MR-DOS/generator_5351_rect_sine/brd1.jpg

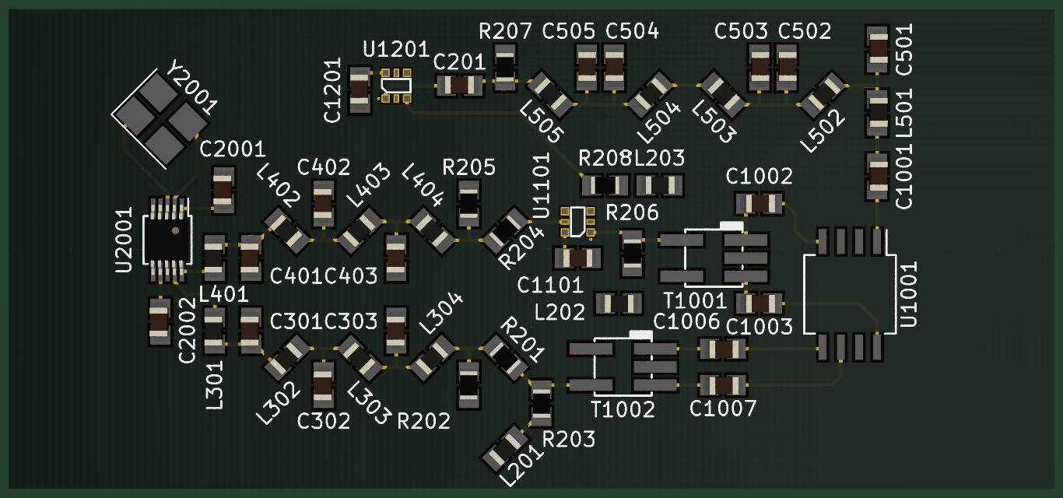
brd1.jpg
