MR-DOS/generator_5351_rect_sine/brd5.jpg

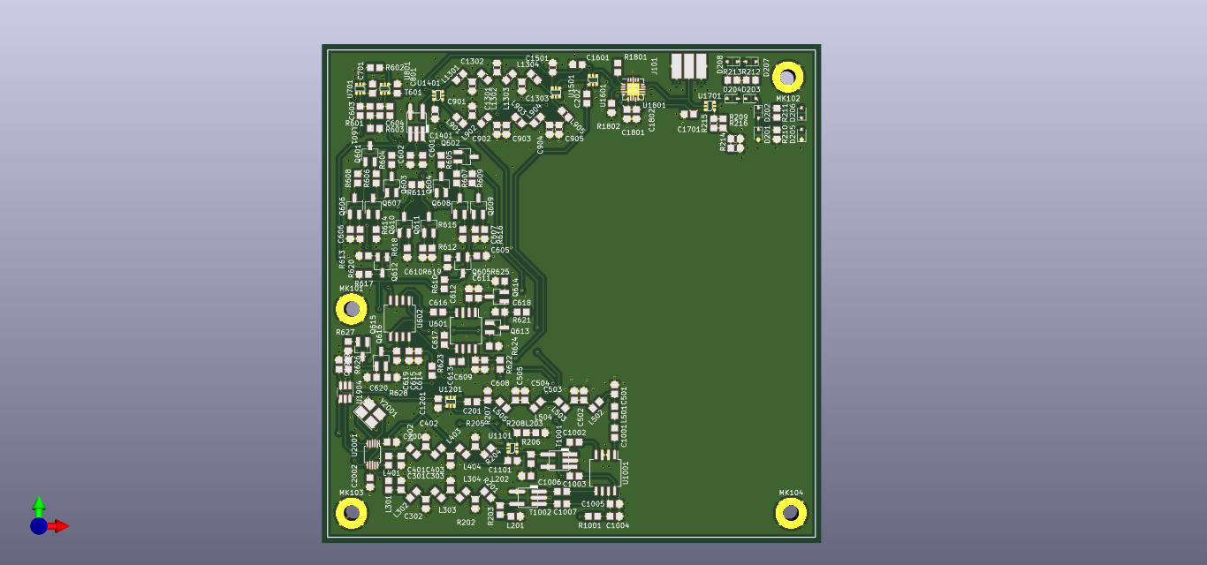
brd5.jpg
