MR-DOS/generator_5351_rect_sine/brd2.jpg

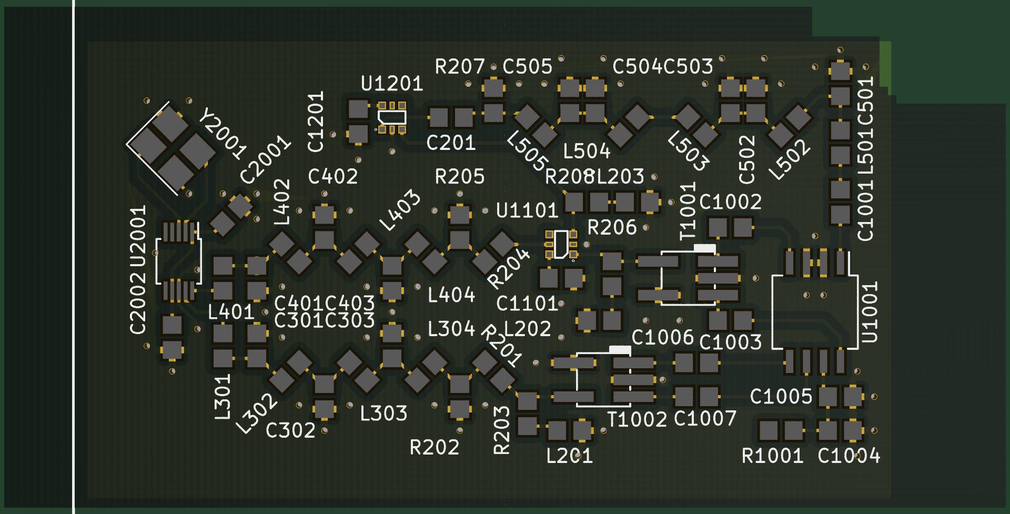
brd2.jpg
