MR-DOS/generator_5351_rect_sine/brd3.jpg

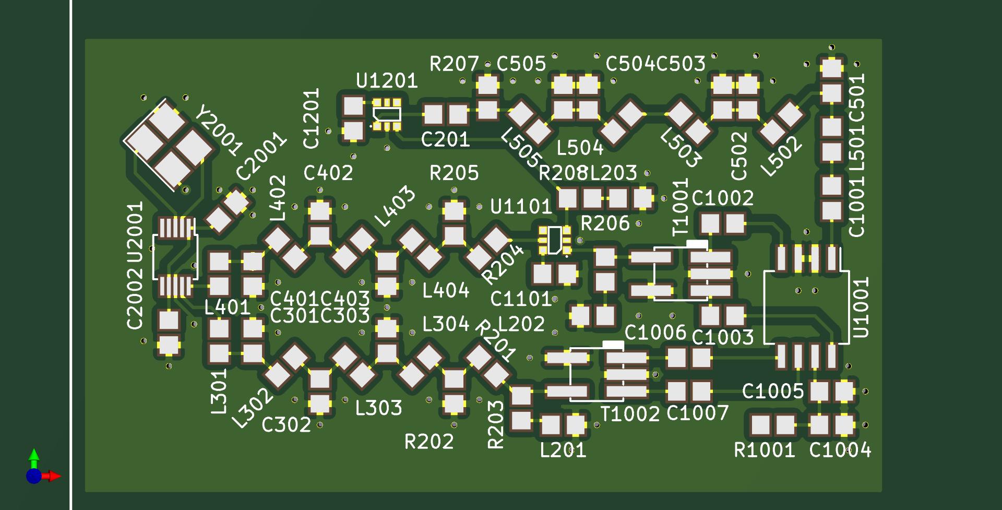
brd3.jpg
