MR-DOS/generator_5351_rect_sine/brd4.jpg

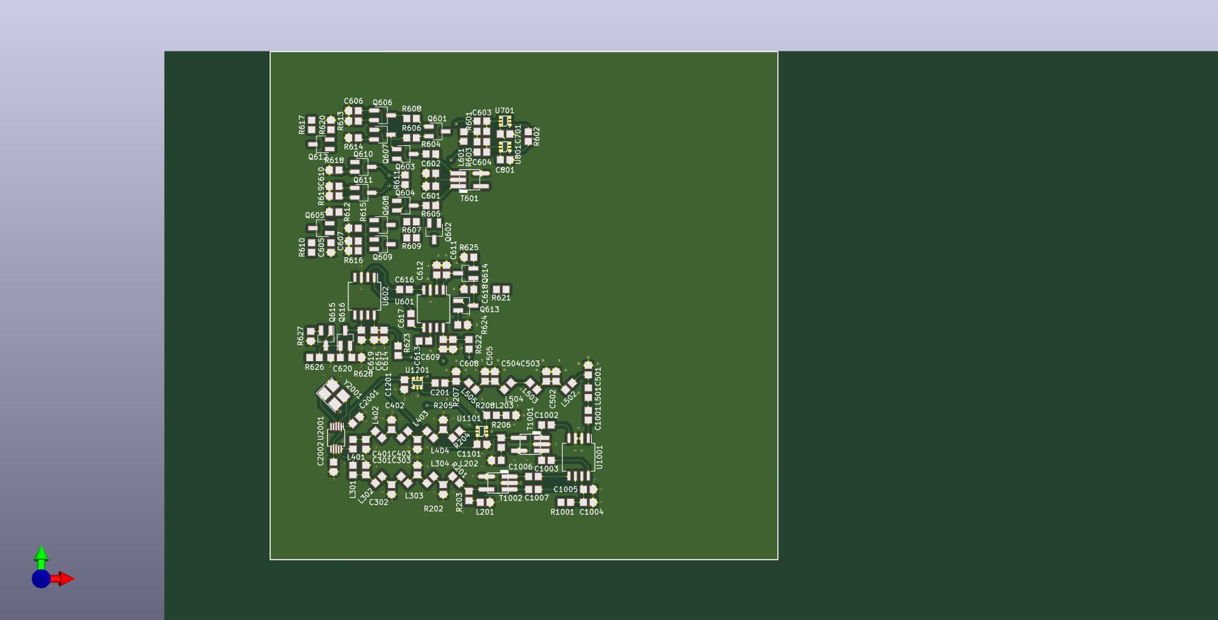
brd4.jpg
