MR-DOS/generator_5351_rect_sine/generator_5351_rect_sine.kicad_pcb

## KiCad design generator_5351_rect_sine.kicad_pcb (2018-12-11)

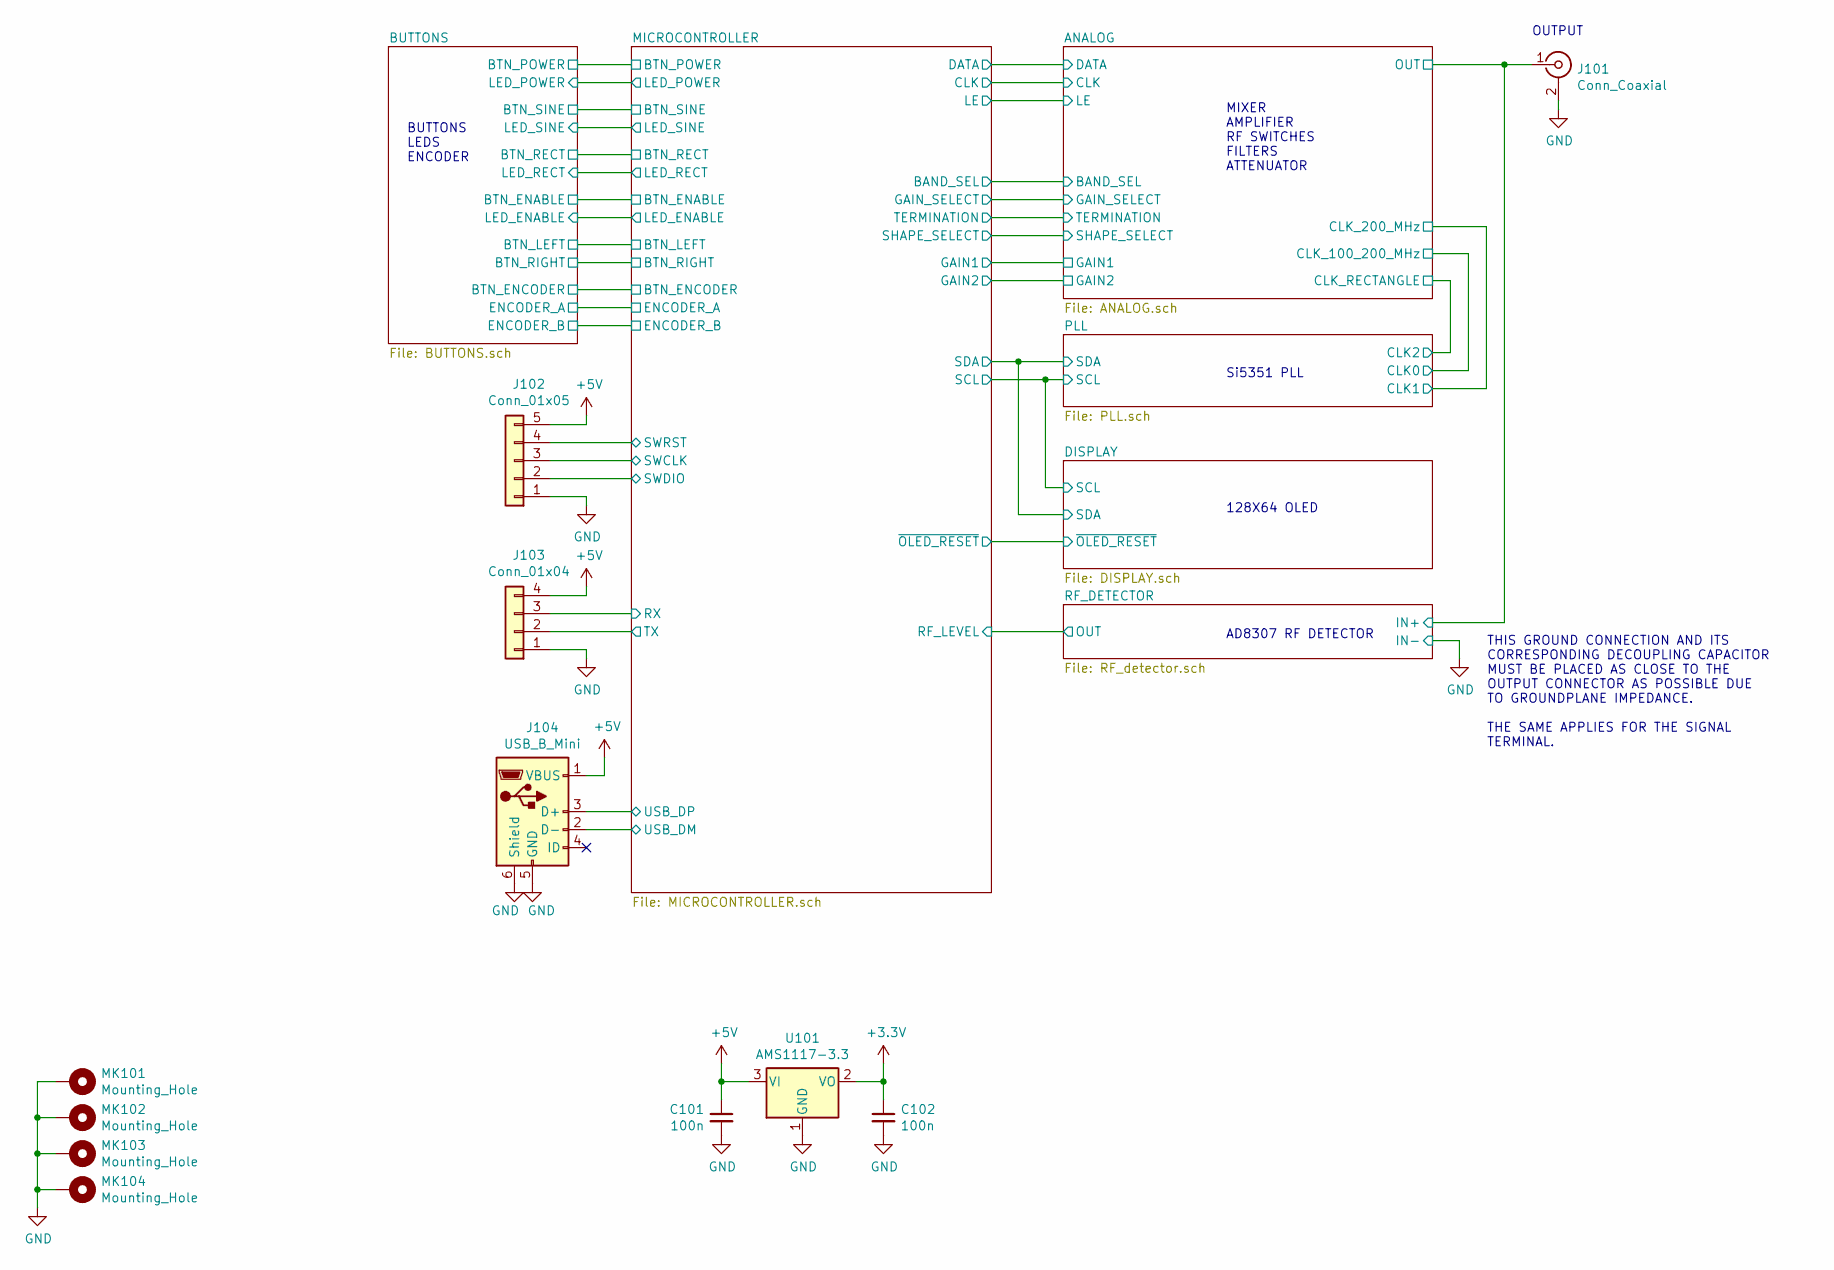
[picture p6: schematic generator_5351_rect_sine.sch]

Parts:
C101, C102: 100n; C_0805_2012Metric_Pad1.33x1.40mm_HandSolder
J101: Conn_Coaxial; Molex_SMA_Jack_Edge_Mount_Chinese
J102: Conn_01x05; JST_VH_B5PS-VH_1x05_P3.96mm_Horizontal
J103: Conn_01x04; JST_VH_B4PS-VH_1x04_P3.96mm_Horizontal
J104: USB_B_Mini; USB_Mini-B_Lumberg_2486_01_Horizontal
MK101, MK102, MK103, MK104: Mounting_Hole; MountingHole_3.2mm_M3_Pad
U101: AMS1117-3.3; SOT-223-3_TabPin2

Connections:
+5V: C101.1, J102.5, J103.4, J104.1 (VBUS), U101.3 (VI); also elsewhere on the board
/MICROCONTROLLER/RX: J103.3; also elsewhere on the board
/MICROCONTROLLER/SWCLK: J102.3; also elsewhere on the board
/MICROCONTROLLER/SWDIO: J102.2; also elsewhere on the board
/MICROCONTROLLER/SWRST: J102.4; also elsewhere on the board
/MICROCONTROLLER/TX: J103.2; also elsewhere on the board
/MICROCONTROLLER/USB_DM: J104.2 (D-); also elsewhere on the board
/MICROCONTROLLER/USB_DP: J104.3 (D+); also elsewhere on the board
/RF_DETECTOR/IN+: J101.1 (In); also elsewhere on the board
SW_GND: C101.2, C102.2, J101.2 (Ext), J102.1, J103.1, J104.5 (GND), J104.6 (Shield), MK101.1, MK102.1, MK103.1, MK104.1, U101.1 (GND); also elsewhere on the board

Notes on the sheet:
THIS GROUND CONNECTION AND ITS CORRESPONDING DECOUPLING CAPACITOR MUST BE PLACED AS CLOSE TO THE OUTPUT CONNECTOR AS POSSIBLE DUE TO GROUNDPLANE IMPEDANCE. THE SAME APPLIES FOR THE SIGNAL TERMINAL.
MIXER AMPLIFIER RF SWITCHES FILTERS ATTENUATOR
Si5351 PLL
128X64 OLED
AD8307 RF DETECTOR
OUTPUT
BUTTONS LEDS ENCODER

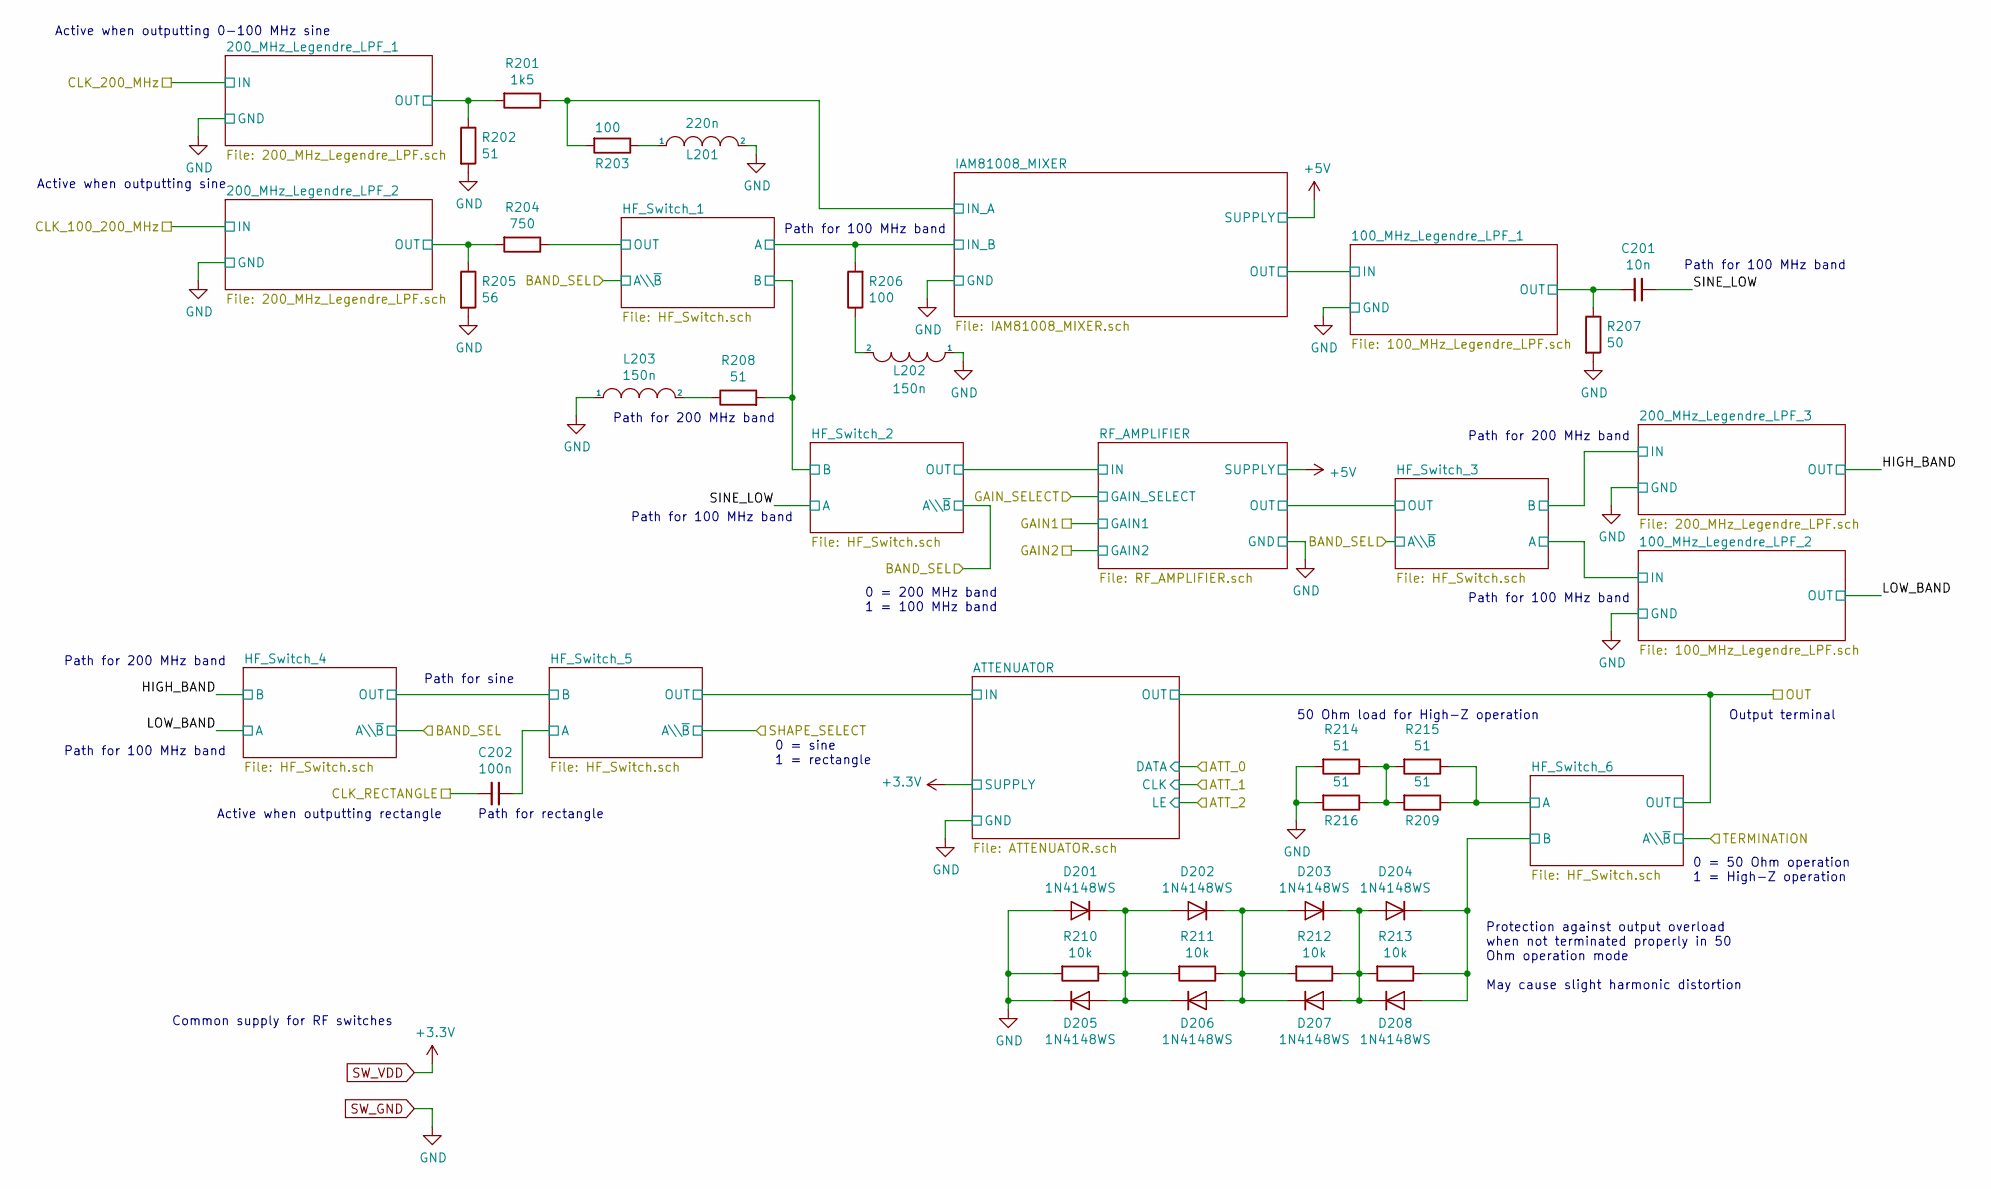
[picture p7: schematic ANALOG.sch]

Parts:
C201: 10n; C_0805_2012Metric_Pad1.33x1.40mm_HandSolder
C202: 100n; C_0805_2012Metric_Pad1.33x1.40mm_HandSolder
D201, D202, D203, D204, D205, D206, D207, D208: 1N4148WS; D_SOD-323
L201: 220n; L_0805_2012Metric_Pad1.33x1.40mm_HandSolder
L202, L203: 150n; L_0805_2012Metric_Pad1.33x1.40mm_HandSolder
R201: 1k5; R_0805_2012Metric_Pad1.33x1.40mm_HandSolder
R202, R208, R209, R214, R215, R216: 51; R_0805_2012Metric_Pad1.33x1.40mm_HandSolder
R203, R206: 100; R_0805_2012Metric_Pad1.33x1.40mm_HandSolder
R204: 750; R_0805_2012Metric_Pad1.33x1.40mm_HandSolder
R205: 56; R_0805_2012Metric_Pad1.33x1.40mm_HandSolder
R207: 50; R_0805_2012Metric_Pad1.33x1.40mm_HandSolder
R210, R211, R212, R213: 10k; R_0805_2012Metric_Pad1.33x1.40mm_HandSolder

Connections:
/ANALOG/100_MHz_Legendre_LPF_1/OUT: C201.2, R207.1; also elsewhere on the board
/ANALOG/200_MHz_Legendre_LPF_1/OUT: R201.2, R202.1; also elsewhere on the board
/ANALOG/200_MHz_Legendre_LPF_2/OUT: R204.2, R205.1; also elsewhere on the board
/ANALOG/HF_Switch_1/A: R206.2; also elsewhere on the board
/ANALOG/HF_Switch_1/B: R208.2; also elsewhere on the board
/ANALOG/HF_Switch_1/OUT: R204.1; also elsewhere on the board
/ANALOG/HF_Switch_5/A: C202.1; also elsewhere on the board
/ANALOG/HF_Switch_6/A: R209.1, R215.1; also elsewhere on the board
/ANALOG/HF_Switch_6/B: D204.1 (K), D208.2 (A), R213.1; also elsewhere on the board
/ANALOG/IAM81008_MIXER/IN_A: R201.1, R203.2; also elsewhere on the board
/ANALOG/SINE_LOW: C201.1; also elsewhere on the board
/PLL/CLK2: C202.2; also elsewhere on the board
unnamed: D201.1 (K), D202.2 (A), D205.2 (A), D206.1 (K), R210.1, R211.2
unnamed: D202.1 (K), D203.2 (A), D206.2 (A), D207.1 (K), R211.1, R212.2
unnamed: D203.1 (K), D204.2 (A), D207.2 (A), D208.1 (K), R212.1, R213.2
unnamed: L201.1, R203.1
unnamed: L202.2, R206.1
unnamed: L203.2, R208.1
unnamed: R209.2, R214.1, R215.2, R216.1
SW_GND: D201.2 (A), D205.1 (K), L201.2, L202.1, L203.1, R202.2, R205.2, R207.2, R210.2, R214.2, R216.2; also elsewhere on the board

Notes on the sheet:
Path for 100 MHz band
Path for 200 MHz band
Common supply for RF switches
Active when outputting 0-100 MHz sine
Active when outputting sine
0 = sine 1 = rectangle
Path for sine
Path for rectangle
Protection against output overload when not terminated properly in 50 Ohm operation mode May cause slight harmonic distortion
50 Ohm load for High-Z operation
0 = 50 Ohm operation 1 = High-Z operation
Output terminal
0 = 200 MHz band 1 = 100 MHz band
Active when outputting rectangle

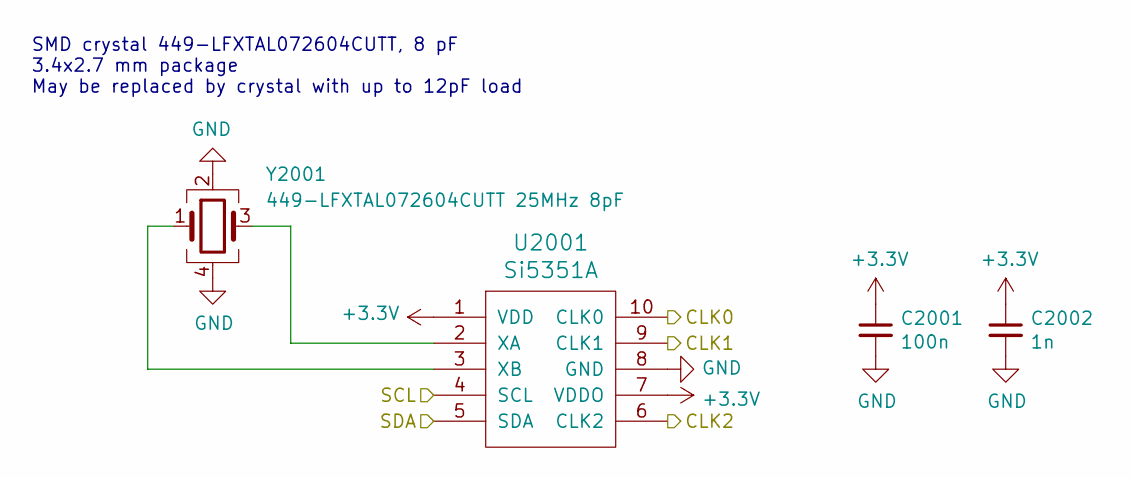
[picture p8: schematic PLL.sch]

Parts:
C2001: 100n; C_0805_2012Metric_Pad1.33x1.40mm_HandSolder
C2002: 1n; C_0805_2012Metric_Pad1.33x1.40mm_HandSolder
U2001: Si5351A; MSOP-10_3x3mm_P0.5mm
Y2001: 449-LFXTAL072604CUTT 25MHz 8pF; Crystal_SMD_3225-4Pin_3.2x2.5mm_HandSoldering

Connections:
/DISPLAY/SCL: U2001.4 (SCL); also elsewhere on the board
/DISPLAY/SDA: U2001.5 (SDA); also elsewhere on the board
/PLL/CLK0: U2001.10 (CLK0); also elsewhere on the board
/PLL/CLK1: U2001.9 (CLK1); also elsewhere on the board
/PLL/CLK2: U2001.6 (CLK2); also elsewhere on the board
unnamed: U2001.2 (XA), Y2001.3
unnamed: U2001.3 (XB), Y2001.1
SW_GND: C2001.2, C2002.2, U2001.8 (GND), Y2001.2, Y2001.4; also elsewhere on the board

Notes on the sheet:
SMD crystal 449-LFXTAL072604CUTT, 8 pF 3.4x2.7 mm package May be replaced by crystal with up to 12pF load

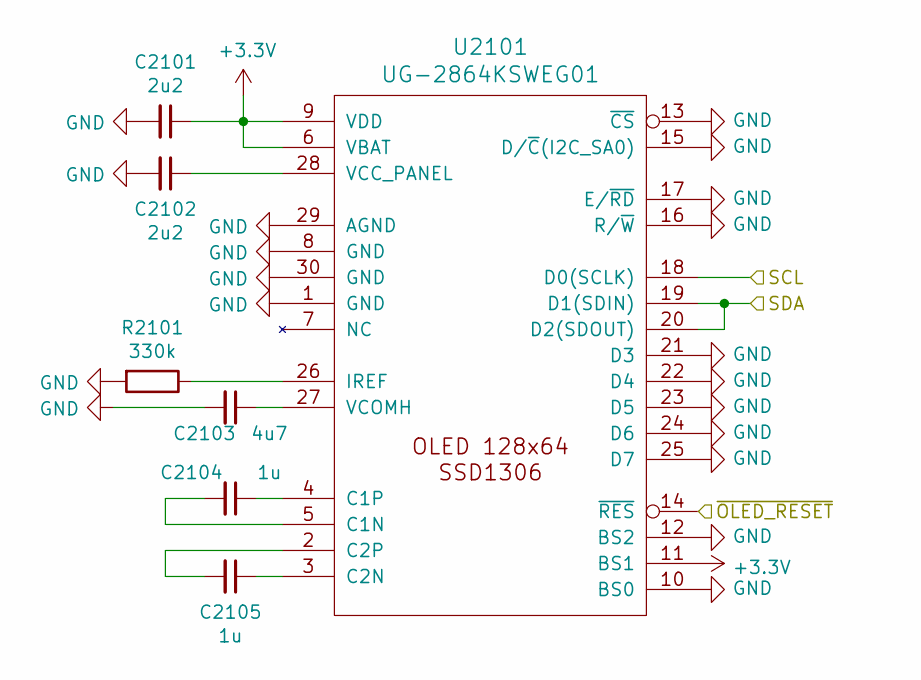
[picture p9: schematic DISPLAY.sch]

Parts:
C2101, C2102: 2u2; C_0805_2012Metric_Pad1.33x1.40mm_HandSolder
C2103: 4u7; C_0805_2012Metric_Pad1.33x1.40mm_HandSolder
C2104, C2105: 1u; C_0805_2012Metric_Pad1.33x1.40mm_HandSolder
R2101: 330k; R_0805_2012Metric_Pad1.33x1.40mm_HandSolder
U2101: UG-2864KSWEG01

Connections:
/DISPLAY/SCL: U2101.18 (D0(SCLK)); also elsewhere on the board
/DISPLAY/SDA: U2101.19 (D1(SDIN)), U2101.20 (D2(SDOUT)); also elsewhere on the board
/DISPLAY/~OLED_RESET: U2101.14 (~RES); also elsewhere on the board
unnamed: C2102.1, U2101.28 (VCC_PANEL)
unnamed: C2103.1, U2101.27 (VCOMH)
unnamed: C2104.1, U2101.4 (C1P)
unnamed: C2104.2, U2101.5 (C1N)
unnamed: C2105.1, U2101.3 (C2N)
unnamed: C2105.2, U2101.2 (C2P)
unnamed: R2101.1, U2101.26 (IREF)
SW_GND: C2101.2, C2102.2, C2103.2, R2101.2, U2101.1 (GND), U2101.8 (GND), U2101.10 (BS0), U2101.12 (BS2), U2101.13 (~CS), U2101.15 (D/~C~(I2C_SA0)), U2101.16 (R/~W), U2101.17 (E/~RD), U2101.21 (D3), U2101.22 (D4), U2101.23 (D5), U2101.24 (D6), U2101.25 (D7), U2101.29 (AGND), U2101.30 (GND); also elsewhere on the board

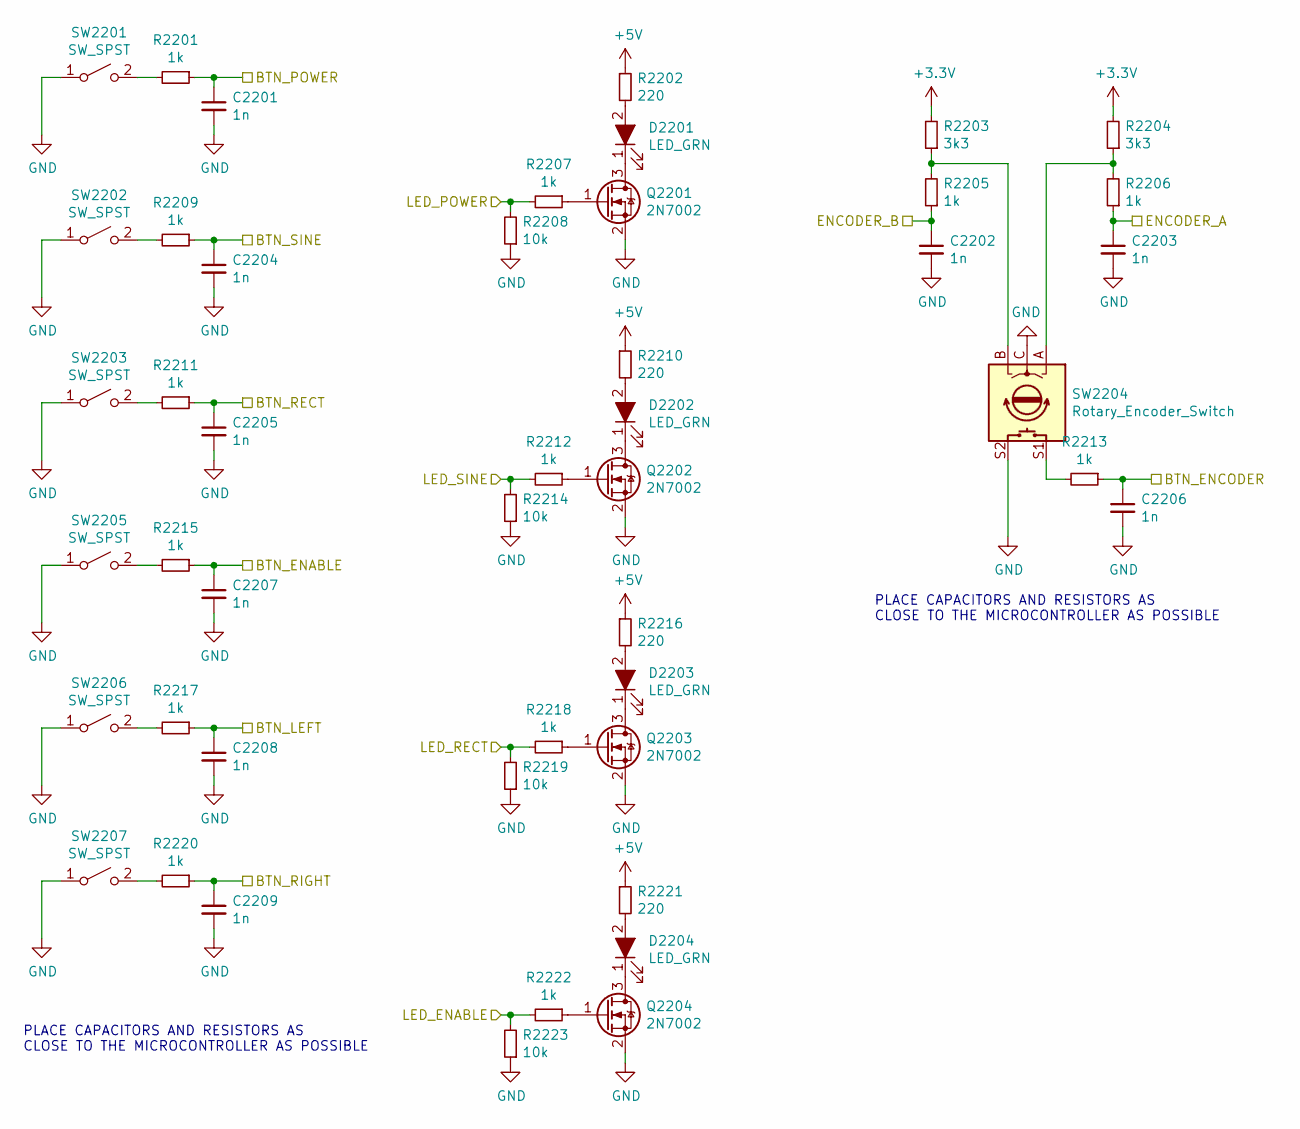
[picture p10: schematic BUTTONS.sch]

Parts:
C2201, C2202, C2203, C2204, C2205, C2206, C2207, C2208, C2209: 1n; C_0805_2012Metric_Pad1.33x1.40mm_HandSolder
D2201, D2202, D2203, D2204: LED_GRN; C_0603_1608Metric_Pad1.05x0.95mm_HandSolder
Q2201, Q2202, Q2203, Q2204: 2N7002; SOT-23_Handsoldering
R2201, R2205, R2206, R2207, R2209, R2211, R2212, R2213, R2215, R2217, R2218, R2220, R2222: 1k; R_0805_2012Metric_Pad1.33x1.40mm_HandSolder
R2202, R2210, R2216, R2221: 220; R_0805_2012Metric_Pad1.33x1.40mm_HandSolder
R2203, R2204: 3k3; R_0805_2012Metric_Pad1.33x1.40mm_HandSolder
R2208, R2214, R2219, R2223: 10k; R_0805_2012Metric_Pad1.33x1.40mm_HandSolder
SW2201, SW2202, SW2203, SW2205, SW2206, SW2207: SW_SPST; SW_SPST_TL3342
SW2204: Rotary_Encoder_Switch; RotaryEncoder_Alps_EC11E-Switch_Vertical_H20mm

Connections:
+5V: R2202.1, R2210.1, R2216.1, R2221.1; also elsewhere on the board
/BUTTONS/BTN_ENABLE: C2207.1, R2215.1; also elsewhere on the board
/BUTTONS/BTN_ENCODER: C2206.1, R2213.1; also elsewhere on the board
/BUTTONS/BTN_LEFT: C2208.1, R2217.1; also elsewhere on the board
/BUTTONS/BTN_POWER: C2201.1, R2201.1; also elsewhere on the board
/BUTTONS/BTN_RECT: C2205.1, R2211.1; also elsewhere on the board
/BUTTONS/BTN_RIGHT: C2209.1, R2220.1; also elsewhere on the board
/BUTTONS/BTN_SINE: C2204.1, R2209.1; also elsewhere on the board
/BUTTONS/ENCODER_A: C2203.1, R2206.1; also elsewhere on the board
/BUTTONS/ENCODER_B: C2202.1, R2205.1; also elsewhere on the board
/BUTTONS/LED_ENABLE: R2222.2, R2223.2; also elsewhere on the board
/BUTTONS/LED_POWER: R2207.2, R2208.2; also elsewhere on the board
/BUTTONS/LED_RECT: R2218.2, R2219.2; also elsewhere on the board
/BUTTONS/LED_SINE: R2212.2, R2214.2; also elsewhere on the board
unnamed: D2201.1 (K), Q2201.3 (D)
unnamed: D2201.2 (A), R2202.2
unnamed: D2202.1 (K), Q2202.3 (D)
unnamed: D2202.2 (A), R2210.2
unnamed: D2203.1 (K), Q2203.3 (D)
unnamed: D2203.2 (A), R2216.2
unnamed: D2204.1 (K), Q2204.3 (D)
unnamed: D2204.2 (A), R2221.2
unnamed: Q2201.1 (G), R2207.1
unnamed: Q2202.1 (G), R2212.1
unnamed: Q2203.1 (G), R2218.1
unnamed: Q2204.1 (G), R2222.1
unnamed: R2201.2, SW2201.2 (B)
unnamed: R2203.1, R2205.2, SW2204.B
unnamed: R2204.1, R2206.2, SW2204.A
unnamed: R2209.2, SW2202.2 (B)
unnamed: R2211.2, SW2203.2 (B)
unnamed: R2213.2, SW2204.S1
unnamed: R2215.2, SW2205.2 (B)
unnamed: R2217.2, SW2206.2 (B)
unnamed: R2220.2, SW2207.2 (B)
SW_GND: C2201.2, C2202.2, C2203.2, C2204.2, C2205.2, C2206.2, C2207.2, C2208.2, C2209.2, Q2201.2 (S), Q2202.2 (S), Q2203.2 (S), Q2204.2 (S), R2208.1, R2214.1, R2219.1, R2223.1, SW2201.1 (A), SW2202.1 (A), SW2203.1 (A), SW2204.C, SW2204.S2, SW2205.1 (A), SW2206.1 (A), SW2207.1 (A); also elsewhere on the board

Notes on the sheet:
PLACE CAPACITORS AND RESISTORS AS CLOSE TO THE MICROCONTROLLER AS POSSIBLE

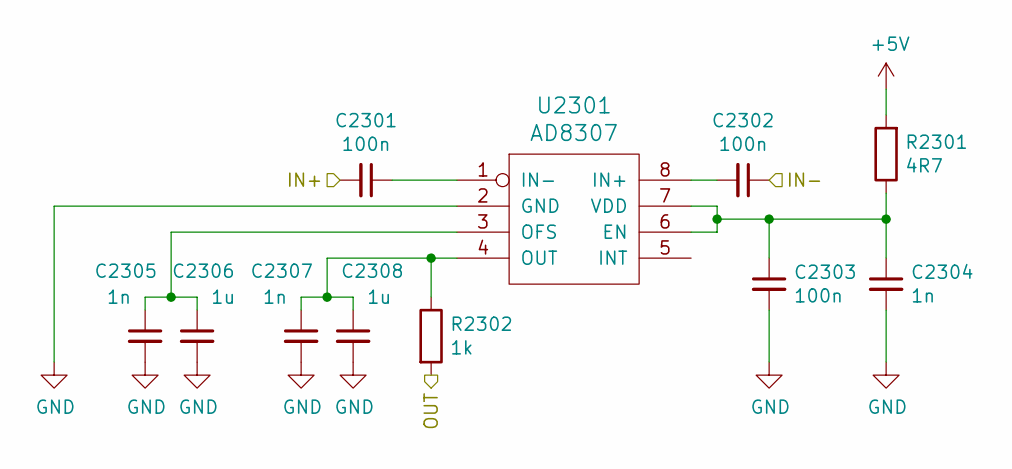
[picture p11: schematic RF_detector.sch]

Parts:
C2301, C2302, C2303: 100n; C_0805_2012Metric_Pad1.33x1.40mm_HandSolder
C2304, C2305, C2307: 1n; C_0805_2012Metric_Pad1.33x1.40mm_HandSolder
C2306, C2308: 1u; C_0805_2012Metric_Pad1.33x1.40mm_HandSolder
R2301: 4R7; R_0805_2012Metric_Pad1.33x1.40mm_HandSolder
R2302: 1k; R_0805_2012Metric_Pad1.33x1.40mm_HandSolder
U2301: AD8307; SOIC-8_3.9x4.9mm_P1.27mm

Connections:
+5V: R2301.2; also elsewhere on the board
/RF_DETECTOR/IN+: C2301.2; also elsewhere on the board
/RF_DETECTOR/OUT: R2302.2; also elsewhere on the board
unnamed: C2301.1, U2301.1 (IN-)
unnamed: C2302.2, U2301.8 (IN+)
unnamed: C2303.1, C2304.1, R2301.1, U2301.6 (EN), U2301.7 (VDD)
unnamed: C2305.1, C2306.1, U2301.3 (OFS)
unnamed: C2307.1, C2308.1, R2302.1, U2301.4 (OUT)
SW_GND: C2302.1, C2303.2, C2304.2, C2305.2, C2306.2, C2307.2, C2308.2, U2301.2 (GND); also elsewhere on the board

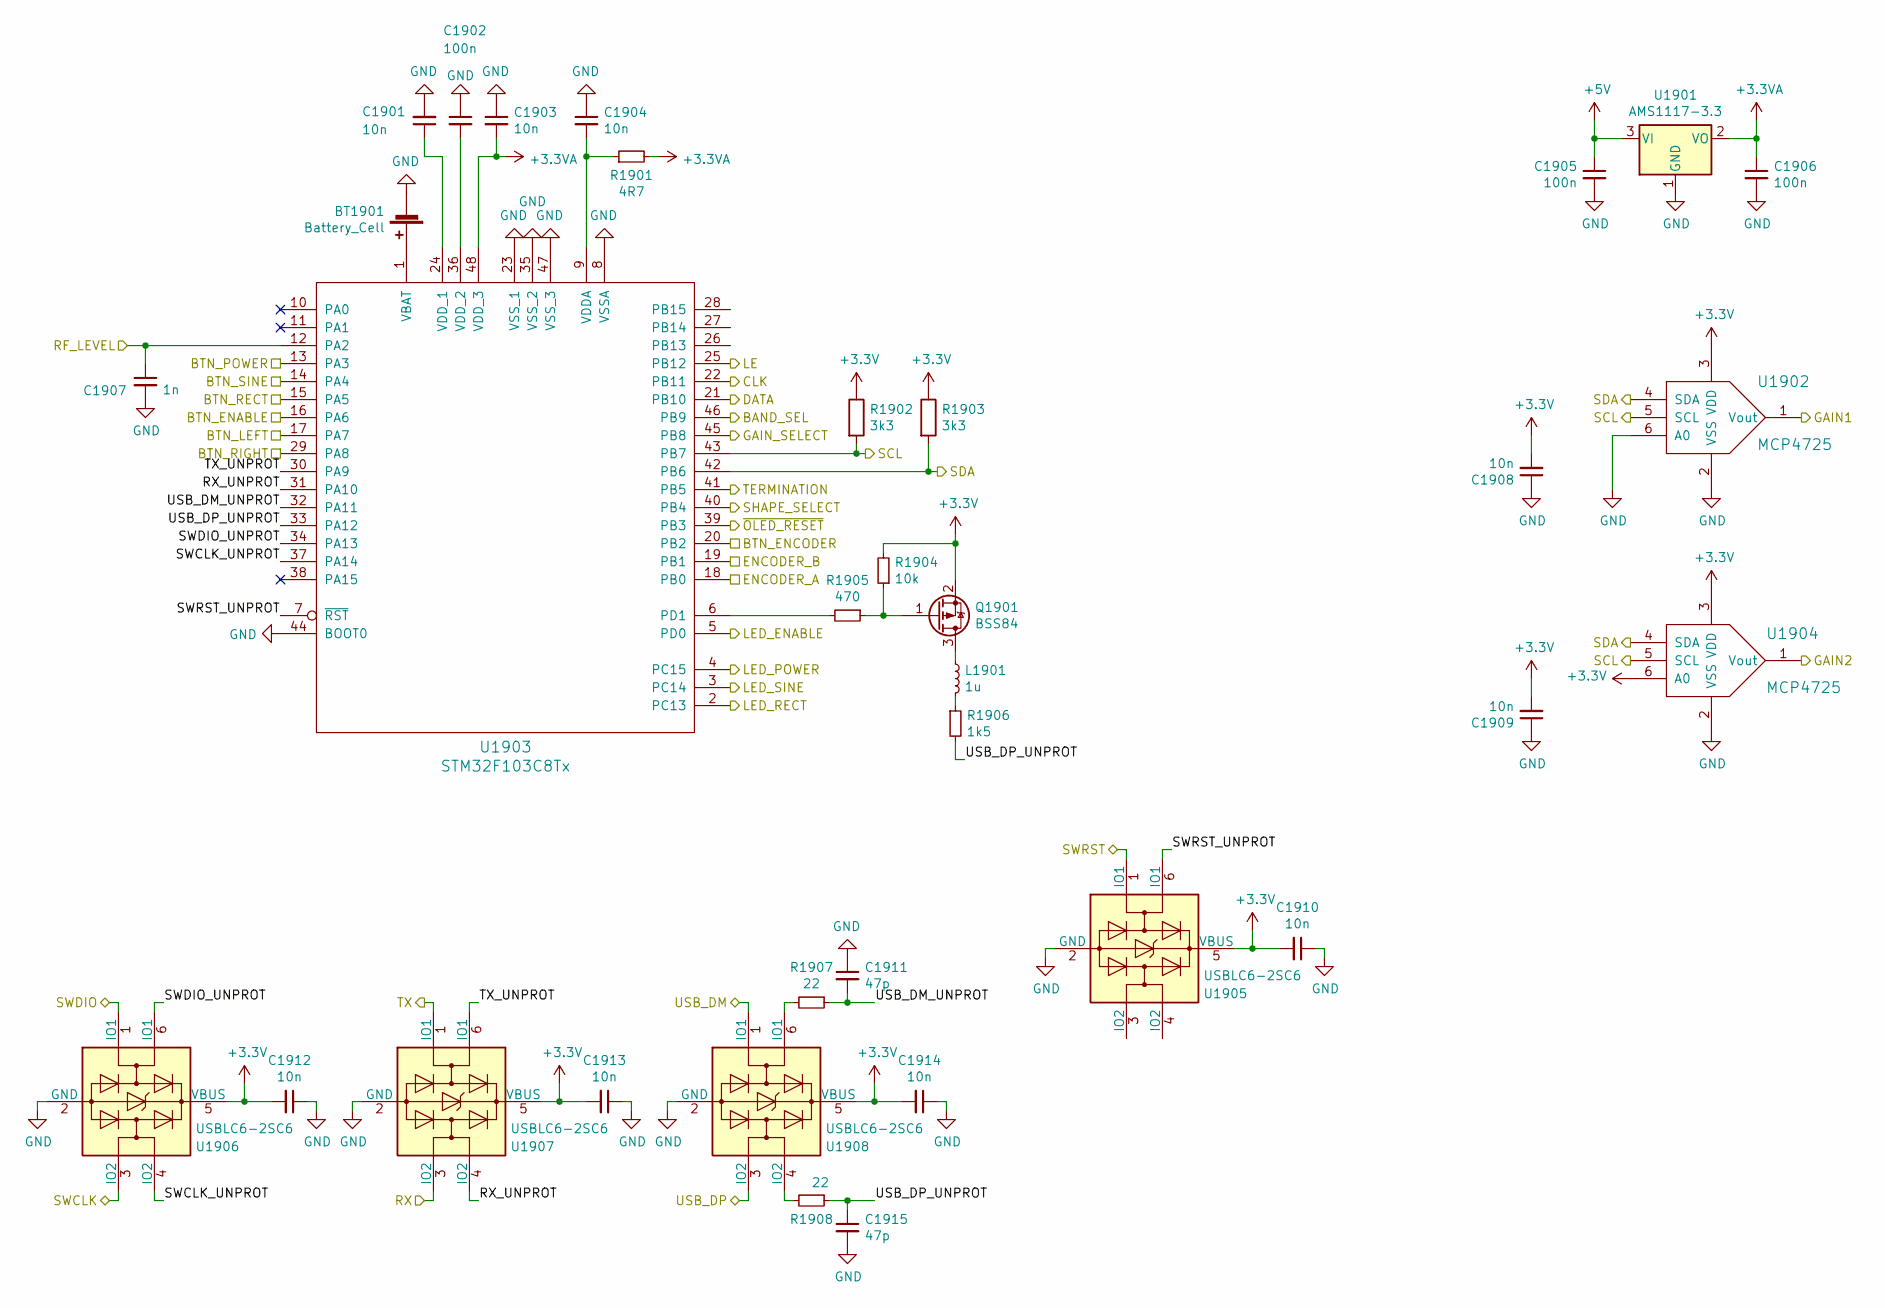
[picture p12: schematic MICROCONTROLLER.sch]

Parts:
BT1901: Battery_Cell; BatteryHolder_Keystone_3034_1x20mm
C1901, C1903, C1904, C1908, C1909, C1910, C1912, C1913, C1914: 10n; C_0805_2012Metric_Pad1.33x1.40mm_HandSolder
C1902, C1905, C1906: 100n; C_0805_2012Metric_Pad1.33x1.40mm_HandSolder
C1907: 1n; C_0805_2012Metric_Pad1.33x1.40mm_HandSolder
C1911, C1915: 47p; C_0805_2012Metric_Pad1.33x1.40mm_HandSolder
L1901: 1u; L_0805_2012Metric_Pad1.33x1.40mm_HandSolder
Q1901: BSS84; SOT-23_Handsoldering
R1901: 4R7; R_0805_2012Metric_Pad1.33x1.40mm_HandSolder
R1902, R1903: 3k3; R_0805_2012Metric_Pad1.33x1.40mm_HandSolder
R1904: 10k; R_0805_2012Metric_Pad1.33x1.40mm_HandSolder
R1905: 470; R_0805_2012Metric_Pad1.33x1.40mm_HandSolder
R1906: 1k5; R_0805_2012Metric_Pad1.33x1.40mm_HandSolder
R1907, R1908: 22; R_0805_2012Metric_Pad1.33x1.40mm_HandSolder
U1901: AMS1117-3.3; SOT-223-3_TabPin2
U1902, U1904: MCP4725; SOT-23-6_Handsoldering
U1903: STM32F103C8Tx; TQFP-48_7x7mm_P0.5mm
U1905, U1906, U1907, U1908: USBLC6-2SC6; SOT-23-6

Connections:
+3.3VA: C1903.2, C1906.1, R1901.2, U1901.2 (VO), U1903.48 (VDD_3)
+5V: C1905.1, U1901.3 (VI); also elsewhere on the board
/ANALOG/BAND_SEL: U1903.46 (PB9); also elsewhere on the board
/ANALOG/GAIN1: U1902.1 (Vout); also elsewhere on the board
/ANALOG/GAIN2: U1904.1 (Vout); also elsewhere on the board
/ANALOG/GAIN_SELECT: U1903.45 (PB8); also elsewhere on the board
/ANALOG/SHAPE_SELECT: U1903.40 (PB4); also elsewhere on the board
/ANALOG/TERMINATION: U1903.41 (PB5); also elsewhere on the board
/BUTTONS/BTN_ENABLE: U1903.16 (PA6); also elsewhere on the board
/BUTTONS/BTN_ENCODER: U1903.20 (PB2); also elsewhere on the board
/BUTTONS/BTN_LEFT: U1903.17 (PA7); also elsewhere on the board
/BUTTONS/BTN_POWER: U1903.13 (PA3); also elsewhere on the board
/BUTTONS/BTN_RECT: U1903.15 (PA5); also elsewhere on the board
/BUTTONS/BTN_RIGHT: U1903.29 (PA8); also elsewhere on the board
/BUTTONS/BTN_SINE: U1903.14 (PA4); also elsewhere on the board
/BUTTONS/ENCODER_A: U1903.18 (PB0); also elsewhere on the board
/BUTTONS/ENCODER_B: U1903.19 (PB1); also elsewhere on the board
/BUTTONS/LED_ENABLE: U1903.5 (PD0); also elsewhere on the board
/BUTTONS/LED_POWER: U1903.4 (PC15); also elsewhere on the board
/BUTTONS/LED_RECT: U1903.2 (PC13); also elsewhere on the board
/BUTTONS/LED_SINE: U1903.3 (PC14); also elsewhere on the board
/DISPLAY/SCL: R1902.2, U1902.5 (SCL), U1903.43 (PB7), U1904.5 (SCL); also elsewhere on the board
/DISPLAY/SDA: R1903.2, U1902.4 (SDA), U1903.42 (PB6), U1904.4 (SDA); also elsewhere on the board
/DISPLAY/~OLED_RESET: U1903.39 (PB3); also elsewhere on the board
/MICROCONTROLLER/CLK: U1903.22 (PB11)
/MICROCONTROLLER/DATA: U1903.21 (PB10)
/MICROCONTROLLER/LE: U1903.25 (PB12)
/MICROCONTROLLER/RX: U1907.3 (IO2); also elsewhere on the board
/MICROCONTROLLER/RX_UNPROT: U1903.31 (PA10), U1907.4 (IO2)
/MICROCONTROLLER/SWCLK: U1906.3 (IO2); also elsewhere on the board
/MICROCONTROLLER/SWCLK_UNPROT: U1903.37 (PA14), U1906.4 (IO2)
/MICROCONTROLLER/SWDIO: U1906.1 (IO1); also elsewhere on the board
/MICROCONTROLLER/SWDIO_UNPROT: U1903.34 (PA13), U1906.6 (IO1)
/MICROCONTROLLER/SWRST: U1905.1 (IO1); also elsewhere on the board
/MICROCONTROLLER/SWRST_UNPROT: U1903.7 (~RST), U1905.6 (IO1)
/MICROCONTROLLER/TX: U1907.1 (IO1); also elsewhere on the board
/MICROCONTROLLER/TX_UNPROT: U1903.30 (PA9), U1907.6 (IO1)
/MICROCONTROLLER/USB_DM: U1908.1 (IO1); also elsewhere on the board
/MICROCONTROLLER/USB_DM_UNPROT: C1911.2, R1907.1, U1903.32 (PA11)
/MICROCONTROLLER/USB_DP: U1908.3 (IO2); also elsewhere on the board
/MICROCONTROLLER/USB_DP_UNPROT: C1915.1, R1906.2, R1908.1, U1903.33 (PA12)
/RF_DETECTOR/OUT: C1907.1, U1903.12 (PA2); also elsewhere on the board
unnamed: BT1901.1 (+), U1903.1 (VBAT)
unnamed: C1901.1, U1903.24 (VDD_1)
unnamed: C1902.2, U1903.36 (VDD_2)
unnamed: C1904.2, R1901.1, U1903.9 (VDDA)
unnamed: L1901.1, Q1901.3 (D)
unnamed: L1901.2, R1906.1
unnamed: Q1901.1 (G), R1904.1, R1905.1
unnamed: R1905.2, U1903.6 (PD1)
unnamed: R1907.2, U1908.6 (IO1)
unnamed: R1908.2, U1908.4 (IO2)
SW_GND: BT1901.2 (-), C1901.2, C1902.1, C1903.1, C1904.1, C1905.2, C1906.2, C1907.2, C1908.1, C1909.1, C1910.1, C1911.1, C1912.1, C1913.1, C1914.1, C1915.2, U1901.1 (GND), U1902.2 (VSS), U1902.6 (A0), U1903.8 (VSSA), U1903.23 (VSS_1), U1903.35 (VSS_2), U1903.44 (BOOT0), U1903.47 (VSS_3), U1904.2 (VSS), U1905.2 (GND), U1906.2 (GND), U1907.2 (GND), U1908.2 (GND); also elsewhere on the board

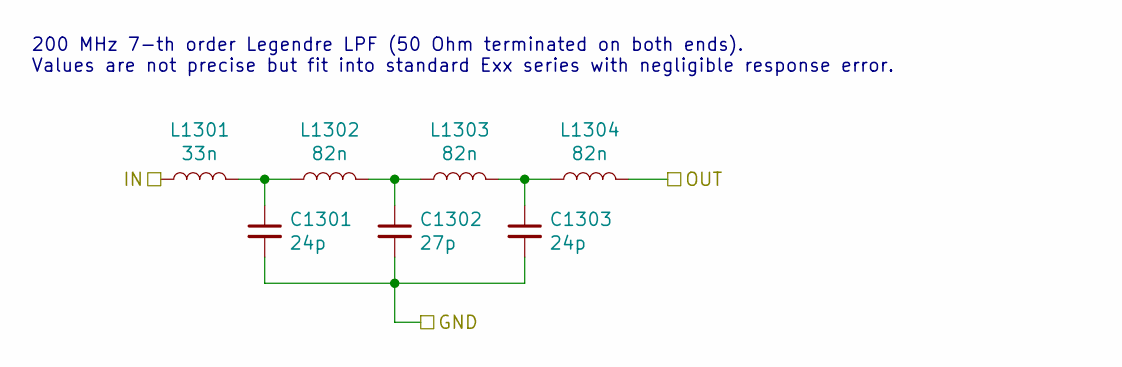
[picture p13: schematic 200_MHz_Legendre_LPF.sch]

Parts:
C301, C303: 24p; C_0805_2012Metric_Pad1.33x1.40mm_HandSolder
C302: 27p; C_0805_2012Metric_Pad1.33x1.40mm_HandSolder
L301: 33n; L_0805_2012Metric_Pad1.33x1.40mm_HandSolder
L302, L303, L304: 82n; L_0805_2012Metric_Pad1.33x1.40mm_HandSolder

Connections:
/ANALOG/200_MHz_Legendre_LPF_1/OUT: L304.2; also elsewhere on the board
/PLL/CLK1: L301.1; also elsewhere on the board
unnamed: C301.1, L301.2, L302.1
unnamed: C302.1, L302.2, L303.1
unnamed: C303.1, L303.2, L304.1
SW_GND: C301.2, C302.2, C303.2; also elsewhere on the board

Parts of its further copies:
C401, C403, C1301, C1303: 24p; C_0805_2012Metric_Pad1.33x1.40mm_HandSolder
C402, C1302: 27p; C_0805_2012Metric_Pad1.33x1.40mm_HandSolder
L401, L1301: 33n; L_0805_2012Metric_Pad1.33x1.40mm_HandSolder
L402, L403, L404, L1302, L1303, L1304: 82n; L_0805_2012Metric_Pad1.33x1.40mm_HandSolder

Connections of its further copies:
/ANALOG/200_MHz_Legendre_LPF_2/OUT: L404.2; also elsewhere on the board
/ANALOG/HF_Switch_3/B: L1301.1; also elsewhere on the board
/ANALOG/HIGH_BAND: L1304.2; also elsewhere on the board
/PLL/CLK0: L401.1; also elsewhere on the board
unnamed: C401.1, L401.2, L402.1
unnamed: C402.1, L402.2, L403.1
unnamed: C403.1, L403.2, L404.1
unnamed: C1301.1, L1301.2, L1302.1
unnamed: C1302.1, L1302.2, L1303.1
unnamed: C1303.1, L1303.2, L1304.1
SW_GND: C401.2, C402.2, C403.2, C1301.2, C1302.2, C1303.2; also elsewhere on the board

Notes on the sheet:
200 MHz 7-th order Legendre LPF (50 Ohm terminated on both ends). Values are not precise but fit into standard Exx series with negligible response error.

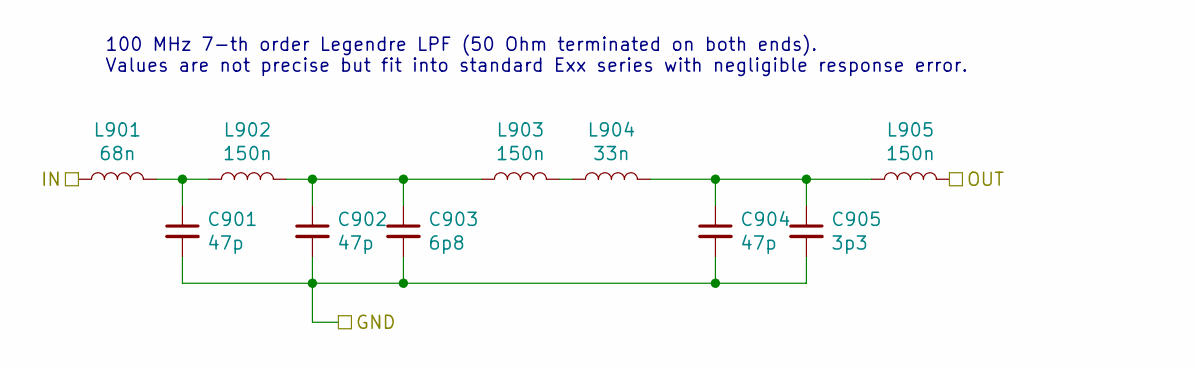
[picture p14: schematic 100_MHz_Legendre_LPF.sch]

Parts:
C501, C502, C504: 47p; C_0805_2012Metric_Pad1.33x1.40mm_HandSolder
C503: 6p8; C_0805_2012Metric_Pad1.33x1.40mm_HandSolder
C505: 3p3; C_0805_2012Metric_Pad1.33x1.40mm_HandSolder
L501: 68n; L_0805_2012Metric_Pad1.33x1.40mm_HandSolder
L502, L503, L505: 150n; L_0805_2012Metric_Pad1.33x1.40mm_HandSolder
L504: 33n; L_0805_2012Metric_Pad1.33x1.40mm_HandSolder

Connections:
/ANALOG/100_MHz_Legendre_LPF_1/IN: L501.1; also elsewhere on the board
/ANALOG/100_MHz_Legendre_LPF_1/OUT: L505.2; also elsewhere on the board
unnamed: C501.1, L501.2, L502.1
unnamed: C502.1, C503.1, L502.2, L503.1
unnamed: C504.1, C505.1, L504.2, L505.1
unnamed: L503.2, L504.1
SW_GND: C501.2, C502.2, C503.2, C504.2, C505.2; also elsewhere on the board

Parts of its further copies:
C901, C902, C904: 47p; C_0805_2012Metric_Pad1.33x1.40mm_HandSolder
C903: 6p8; C_0805_2012Metric_Pad1.33x1.40mm_HandSolder
C905: 3p3; C_0805_2012Metric_Pad1.33x1.40mm_HandSolder
L901: 68n; L_0805_2012Metric_Pad1.33x1.40mm_HandSolder
L902, L903, L905: 150n; L_0805_2012Metric_Pad1.33x1.40mm_HandSolder
L904: 33n; L_0805_2012Metric_Pad1.33x1.40mm_HandSolder

Connections of its further copies:
/ANALOG/HF_Switch_3/A: L901.1; also elsewhere on the board
/ANALOG/LOW_BAND: L905.2; also elsewhere on the board
unnamed: C901.1, L901.2, L902.1
unnamed: C902.1, C903.1, L902.2, L903.1
unnamed: C904.1, C905.1, L904.2, L905.1
unnamed: L903.2, L904.1
SW_GND: C901.2, C902.2, C903.2, C904.2, C905.2; also elsewhere on the board

Notes on the sheet:
100 MHz 7-th order Legendre LPF (50 Ohm terminated on both ends). Values are not precise but fit into standard Exx series with negligible response error.
