MR-DOS/generator_5351_rect_sine/generator_5351_rect_sine.kicad_pcb

## KiCad design generator_5351_rect_sine.kicad_pcb (continued)

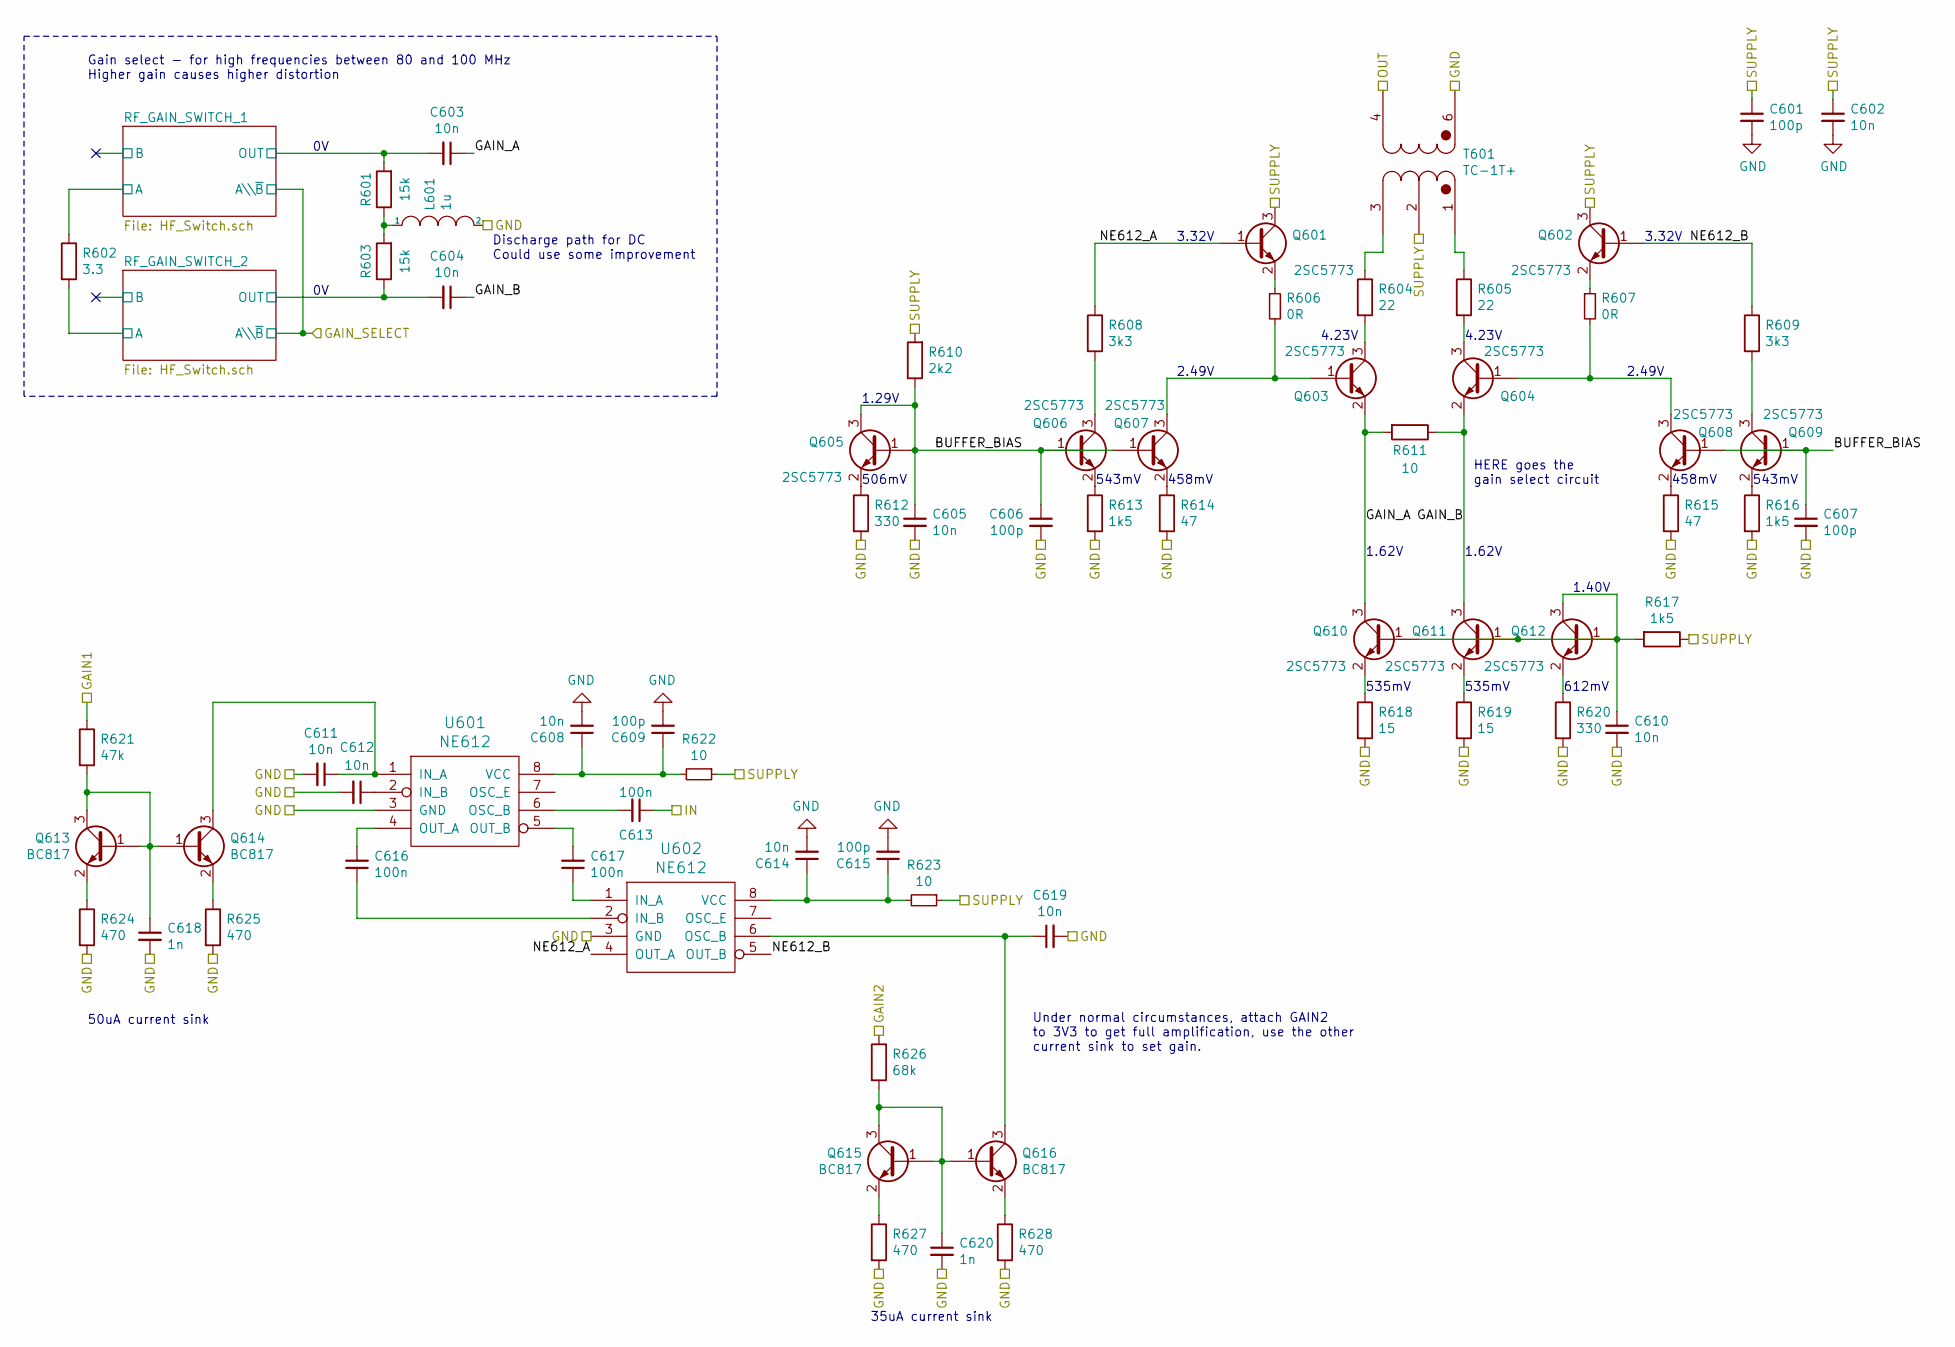
[picture p15: schematic RF_AMPLIFIER.sch]

Parts:
C601, C606, C607, C609, C615: 100p; C_0805_2012Metric_Pad1.33x1.40mm_HandSolder
C602, C603, C604, C605, C608, C610, C611, C612, C614, C619: 10n; C_0805_2012Metric_Pad1.33x1.40mm_HandSolder
C613, C616, C617: 100n; C_0805_2012Metric_Pad1.33x1.40mm_HandSolder
C618, C620: 1n; C_0805_2012Metric_Pad1.33x1.40mm_HandSolder
L601: 1u; L_0805_2012Metric_Pad1.33x1.40mm_HandSolder
Q601, Q602, Q603, Q604, Q605, Q606, Q607, Q608, Q609, Q610, Q611, Q612: 2SC5773; SC-59_Handsoldering
Q613, Q614, Q615, Q616: BC817; SOT-23_Handsoldering
R601, R603: 15k; R_0805_2012Metric_Pad1.33x1.40mm_HandSolder
R602: 3.3; R_0805_2012Metric_Pad1.33x1.40mm_HandSolder
R604, R605: 22; R_0805_2012Metric_Pad1.33x1.40mm_HandSolder
R606, R607: 0R; R_0805_2012Metric_Pad1.33x1.40mm_HandSolder
R608, R609: 3k3; R_0805_2012Metric_Pad1.33x1.40mm_HandSolder
R610: 2k2; R_0805_2012Metric_Pad1.33x1.40mm_HandSolder
R611, R622, R623: 10; R_0805_2012Metric_Pad1.33x1.40mm_HandSolder
R612, R620: 330; R_0805_2012Metric_Pad1.33x1.40mm_HandSolder
R613, R616, R617: 1k5; R_0805_2012Metric_Pad1.33x1.40mm_HandSolder
R614, R615: 47; R_0805_2012Metric_Pad1.33x1.40mm_HandSolder
R618, R619: 15; R_0805_2012Metric_Pad1.33x1.40mm_HandSolder
R621: 47k; R_0805_2012Metric_Pad1.33x1.40mm_HandSolder
R624, R625, R627, R628: 470; R_0805_2012Metric_Pad1.33x1.40mm_HandSolder
R626: 68k; R_0805_2012Metric_Pad1.33x1.40mm_HandSolder
T601: TC-1T+; AT224-1A
U601, U602: NE612; SO-8_5.3x6.2mm_P1.27mm

Connections:
+5V: C601.1, C602.1, Q601.3, Q602.3, R610.2, R617.1, R622.1, R623.1, T601.2 (SC); also elsewhere on the board
/ANALOG/GAIN1: R621.1; also elsewhere on the board
/ANALOG/GAIN2: R626.1; also elsewhere on the board
/ANALOG/HF_Switch_3/OUT: T601.4 (AB); also elsewhere on the board
/ANALOG/RF_AMPLIFIER/BUFFER_BIAS: C605.1, C606.1, C607.1, Q605.1, Q605.3, Q606.1, Q607.1, Q608.1, Q609.1, R610.1
/ANALOG/RF_AMPLIFIER/GAIN_A: C603.1, Q603.2, Q610.3, R611.2
/ANALOG/RF_AMPLIFIER/GAIN_B: C604.1, Q604.2, Q611.3, R611.1
/ANALOG/RF_AMPLIFIER/IN: C613.1; also elsewhere on the board
/ANALOG/RF_AMPLIFIER/NE612_A: Q601.1, R608.1, U602.4 (OUT_A)
/ANALOG/RF_AMPLIFIER/NE612_B: Q602.1, R609.1, U602.5 (OUT_B)
/ANALOG/RF_AMPLIFIER/RF_GAIN_SWITCH_1/A: R602.1; also elsewhere on the board
/ANALOG/RF_AMPLIFIER/RF_GAIN_SWITCH_1/OUT: C603.2, R601.2; also elsewhere on the board
/ANALOG/RF_AMPLIFIER/RF_GAIN_SWITCH_2/A: R602.2; also elsewhere on the board
/ANALOG/RF_AMPLIFIER/RF_GAIN_SWITCH_2/OUT: C604.2, R603.1; also elsewhere on the board
unnamed: C608.1, C609.1, R622.2, U601.8 (VCC)
unnamed: C610.1, Q610.1, Q611.1, Q612.1, Q612.3, R617.2
unnamed: C611.1, Q614.3 (C), U601.1 (IN_A)
unnamed: C612.1, U601.2 (IN_B)
unnamed: C613.2, U601.6 (OSC_B)
unnamed: C614.1, C615.1, R623.2, U602.8 (VCC)
unnamed: C616.1, U602.2 (IN_B)
unnamed: C616.2, U601.4 (OUT_A)
unnamed: C617.1, U602.1 (IN_A)
unnamed: C617.2, U601.5 (OUT_B)
unnamed: C618.1, Q613.1 (B), Q613.3 (C), Q614.1 (B), R621.2
unnamed: C619.1, Q616.3 (C), U602.6 (OSC_B)
unnamed: C620.1, Q615.1 (B), Q615.3 (C), Q616.1 (B), R626.2
unnamed: L601.1, R601.1, R603.2
unnamed: Q601.2, R606.1
unnamed: Q602.2, R607.1
unnamed: Q603.1, Q607.3, R606.2
unnamed: Q603.3, R604.2
unnamed: Q604.1, Q608.3, R607.2
unnamed: Q604.3, R605.2
unnamed: Q605.2, R612.1
unnamed: Q606.2, R613.1
unnamed: Q606.3, R608.2
unnamed: Q607.2, R614.1
unnamed: Q608.2, R615.1
unnamed: Q609.2, R616.1
unnamed: Q609.3, R609.2
unnamed: Q610.2, R618.1
unnamed: Q611.2, R619.1
unnamed: Q612.2, R620.1
unnamed: Q613.2 (E), R624.1
unnamed: Q614.2 (E), R625.1
unnamed: Q615.2 (E), R627.1
unnamed: Q616.2 (E), R628.1
unnamed: R604.1, T601.3 (SA)
unnamed: R605.1, T601.1 (SB)
SW_GND: C601.2, C602.2, C605.2, C606.2, C607.2, C608.2, C609.2, C610.2, C611.2, C612.2, C614.2, C615.2, C618.2, C619.2, C620.2, L601.2, R612.2, R613.2, R614.2, R615.2, R616.2, R618.2, R619.2, R620.2, R624.2, R625.2, R627.2, R628.2, T601.6 (AA), U601.3 (GND), U602.3 (GND); also elsewhere on the board

Notes on the sheet:
50uA current sink
35uA current sink
3.32V
2.49V
1.62V
535mV
612mV
1.40V
543mV
458mV
4.23V
Gain select - for high frequencies between 80 and 100 MHz Higher gain causes higher distortion
1.29V
506mV
Under normal circumstances, attach GAIN2 to 3V3 to get full amplification, use the other current sink to set gain.
Discharge path for DC Could use some improvement
HERE goes the gain select circuit

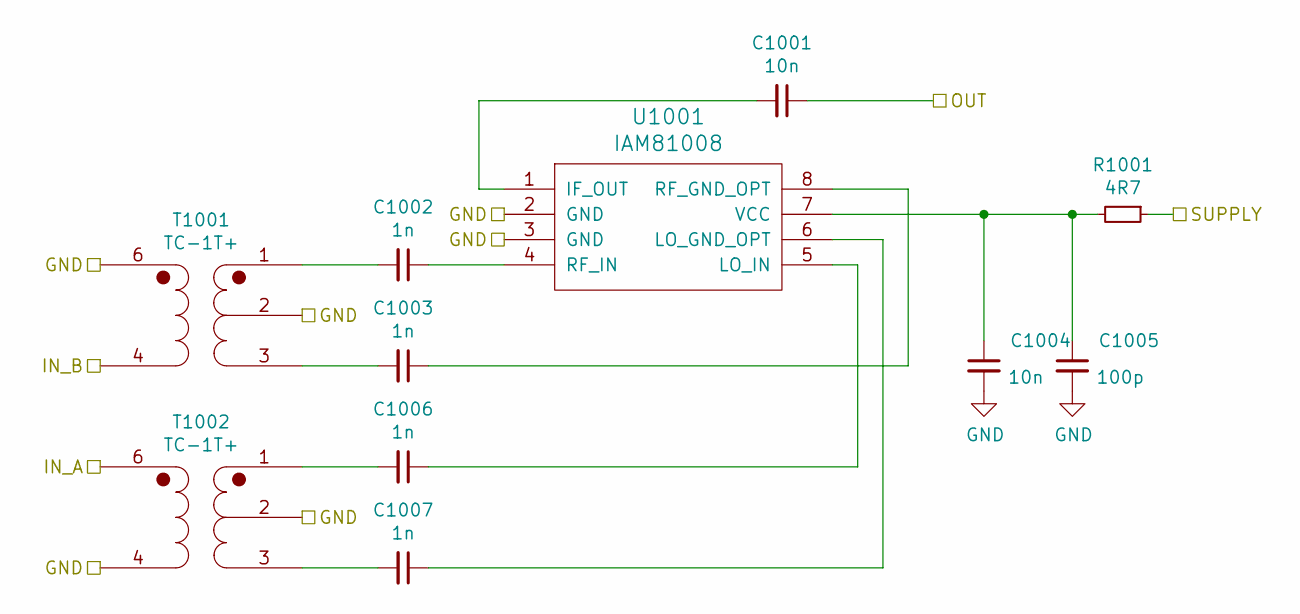
[picture p16: schematic IAM81008_MIXER.sch]

Parts:
C1001, C1004: 10n; C_0805_2012Metric_Pad1.33x1.40mm_HandSolder
C1002, C1003, C1006, C1007: 1n; C_0805_2012Metric_Pad1.33x1.40mm_HandSolder
C1005: 100p; C_0805_2012Metric_Pad1.33x1.40mm_HandSolder
R1001: 4R7; R_0805_2012Metric_Pad1.33x1.40mm_HandSolder
T1001, T1002: TC-1T+; AT224-1A
U1001: IAM81008; SO-8_5.3x6.2mm_P1.27mm

Connections:
+5V: R1001.1; also elsewhere on the board
/ANALOG/100_MHz_Legendre_LPF_1/IN: C1001.1; also elsewhere on the board
/ANALOG/HF_Switch_1/A: T1001.4 (AB); also elsewhere on the board
/ANALOG/IAM81008_MIXER/IN_A: T1002.6 (AA); also elsewhere on the board
unnamed: C1001.2, U1001.1 (IF_OUT)
unnamed: C1002.1, U1001.4 (RF_IN)
unnamed: C1002.2, T1001.1 (SB)
unnamed: C1003.1, U1001.8 (RF_GND_OPT)
unnamed: C1003.2, T1001.3 (SA)
unnamed: C1004.1, C1005.1, R1001.2, U1001.7 (VCC)
unnamed: C1006.1, U1001.5 (LO_IN)
unnamed: C1006.2, T1002.1 (SB)
unnamed: C1007.1, U1001.6 (LO_GND_OPT)
unnamed: C1007.2, T1002.3 (SA)
SW_GND: C1004.2, C1005.2, T1001.2 (SC), T1001.6 (AA), T1002.2 (SC), T1002.4 (AB), U1001.2 (GND), U1001.3 (GND); also elsewhere on the board

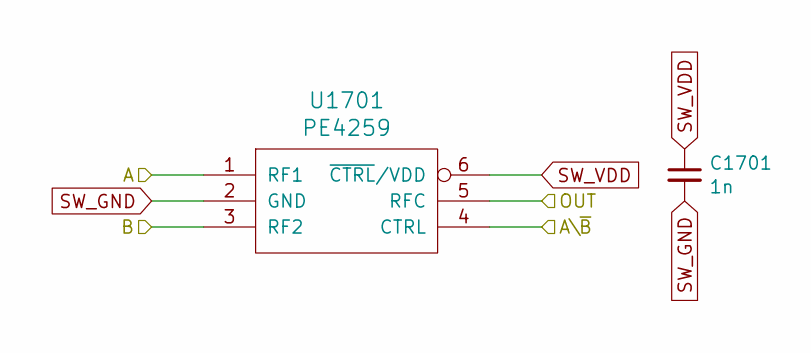
[picture p17: schematic HF_Switch.sch]

Parts:
C1101: 1n; C_0805_2012Metric_Pad1.33x1.40mm_HandSolder
U1101: PE4259; SOT363(TSSOP6)

Connections:
/ANALOG/BAND_SEL: U1101.4 (CTRL); also elsewhere on the board
/ANALOG/HF_Switch_1/A: U1101.1 (RF1); also elsewhere on the board
/ANALOG/HF_Switch_1/B: U1101.3 (RF2); also elsewhere on the board
/ANALOG/HF_Switch_1/OUT: U1101.5 (RFC); also elsewhere on the board
SW_GND: C1101.2, U1101.2 (GND); also elsewhere on the board

Parts of its further copies:
C701, C801, C1201, C1401, C1501, C1601, C1701: 1n; C_0805_2012Metric_Pad1.33x1.40mm_HandSolder
U701, U801, U1201, U1401, U1501, U1601, U1701: PE4259; SOT363(TSSOP6)

Connections of its further copies:
/ANALOG/ATTENUATOR/IN: U1601.5 (RFC); also elsewhere on the board
/ANALOG/BAND_SEL: U1201.4 (CTRL), U1401.4 (CTRL), U1501.4 (CTRL); also elsewhere on the board
/ANALOG/GAIN_SELECT: U701.4 (CTRL), U801.4 (CTRL); also elsewhere on the board
/ANALOG/HF_Switch_1/B: U1201.3 (RF2); also elsewhere on the board
/ANALOG/HF_Switch_3/A: U1401.1 (RF1); also elsewhere on the board
/ANALOG/HF_Switch_3/B: U1401.3 (RF2); also elsewhere on the board
/ANALOG/HF_Switch_3/OUT: U1401.5 (RFC); also elsewhere on the board
/ANALOG/HF_Switch_5/A: U1601.1 (RF1); also elsewhere on the board
/ANALOG/HF_Switch_5/B: U1501.5 (RFC), U1601.3 (RF2)
/ANALOG/HF_Switch_6/A: U1701.1 (RF1); also elsewhere on the board
/ANALOG/HF_Switch_6/B: U1701.3 (RF2); also elsewhere on the board
/ANALOG/HIGH_BAND: U1501.3 (RF2); also elsewhere on the board
/ANALOG/LOW_BAND: U1501.1 (RF1); also elsewhere on the board
/ANALOG/RF_AMPLIFIER/IN: U1201.5 (RFC); also elsewhere on the board
/ANALOG/RF_AMPLIFIER/RF_GAIN_SWITCH_1/A: U701.1 (RF1); also elsewhere on the board
/ANALOG/RF_AMPLIFIER/RF_GAIN_SWITCH_1/B: U701.3 (RF2)
/ANALOG/RF_AMPLIFIER/RF_GAIN_SWITCH_1/OUT: U701.5 (RFC); also elsewhere on the board
/ANALOG/RF_AMPLIFIER/RF_GAIN_SWITCH_2/A: U801.1 (RF1); also elsewhere on the board
/ANALOG/RF_AMPLIFIER/RF_GAIN_SWITCH_2/B: U801.3 (RF2)
/ANALOG/RF_AMPLIFIER/RF_GAIN_SWITCH_2/OUT: U801.5 (RFC); also elsewhere on the board
/ANALOG/SHAPE_SELECT: U1601.4 (CTRL); also elsewhere on the board
/ANALOG/SINE_LOW: U1201.1 (RF1); also elsewhere on the board
/ANALOG/TERMINATION: U1701.4 (CTRL); also elsewhere on the board
/RF_DETECTOR/IN+: U1701.5 (RFC); also elsewhere on the board
SW_GND: C701.2, C801.2, C1201.2, C1401.2, C1501.2, C1601.2, C1701.2, U701.2 (GND), U801.2 (GND), U1201.2 (GND), U1401.2 (GND), U1501.2 (GND), U1601.2 (GND), U1701.2 (GND); also elsewhere on the board

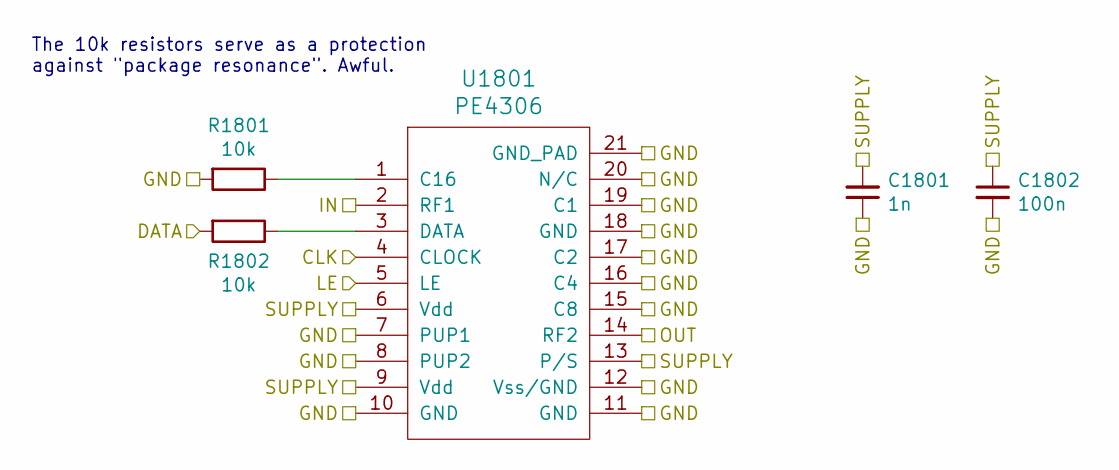
[picture p18: schematic ATTENUATOR.sch]

Parts:
C1801: 1n; C_0805_2012Metric_Pad1.33x1.40mm_HandSolder
C1802: 100n; C_0805_2012Metric_Pad1.33x1.40mm_HandSolder
R1801, R1802: 10k; R_0805_2012Metric_Pad1.33x1.40mm_HandSolder
U1801: PE4306; QFN-20-1EP_4x4mm_Pitch0.5mm

Connections:
/ANALOG/ATTENUATOR/IN: U1801.2 (RF1); also elsewhere on the board
/ANALOG/ATT_0: R1802.2
/ANALOG/ATT_1: U1801.4 (CLOCK)
/ANALOG/ATT_2: U1801.5 (LE)
/RF_DETECTOR/IN+: U1801.14 (RF2); also elsewhere on the board
unnamed: R1801.1, U1801.1 (C16)
unnamed: R1802.1, U1801.3 (DATA)
SW_GND: C1801.1, C1802.2, R1801.2, U1801.7 (PUP1), U1801.8 (PUP2), U1801.10 (GND), U1801.11 (GND), U1801.12 (Vss/GND), U1801.15 (C8), U1801.16 (C4), U1801.17 (C2), U1801.18 (GND), U1801.19 (C1), U1801.20 (N/C), U1801.21 (GND_PAD); also elsewhere on the board

Notes on the sheet:
The 10k resistors serve as a protection against "package resonance". Awful.

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
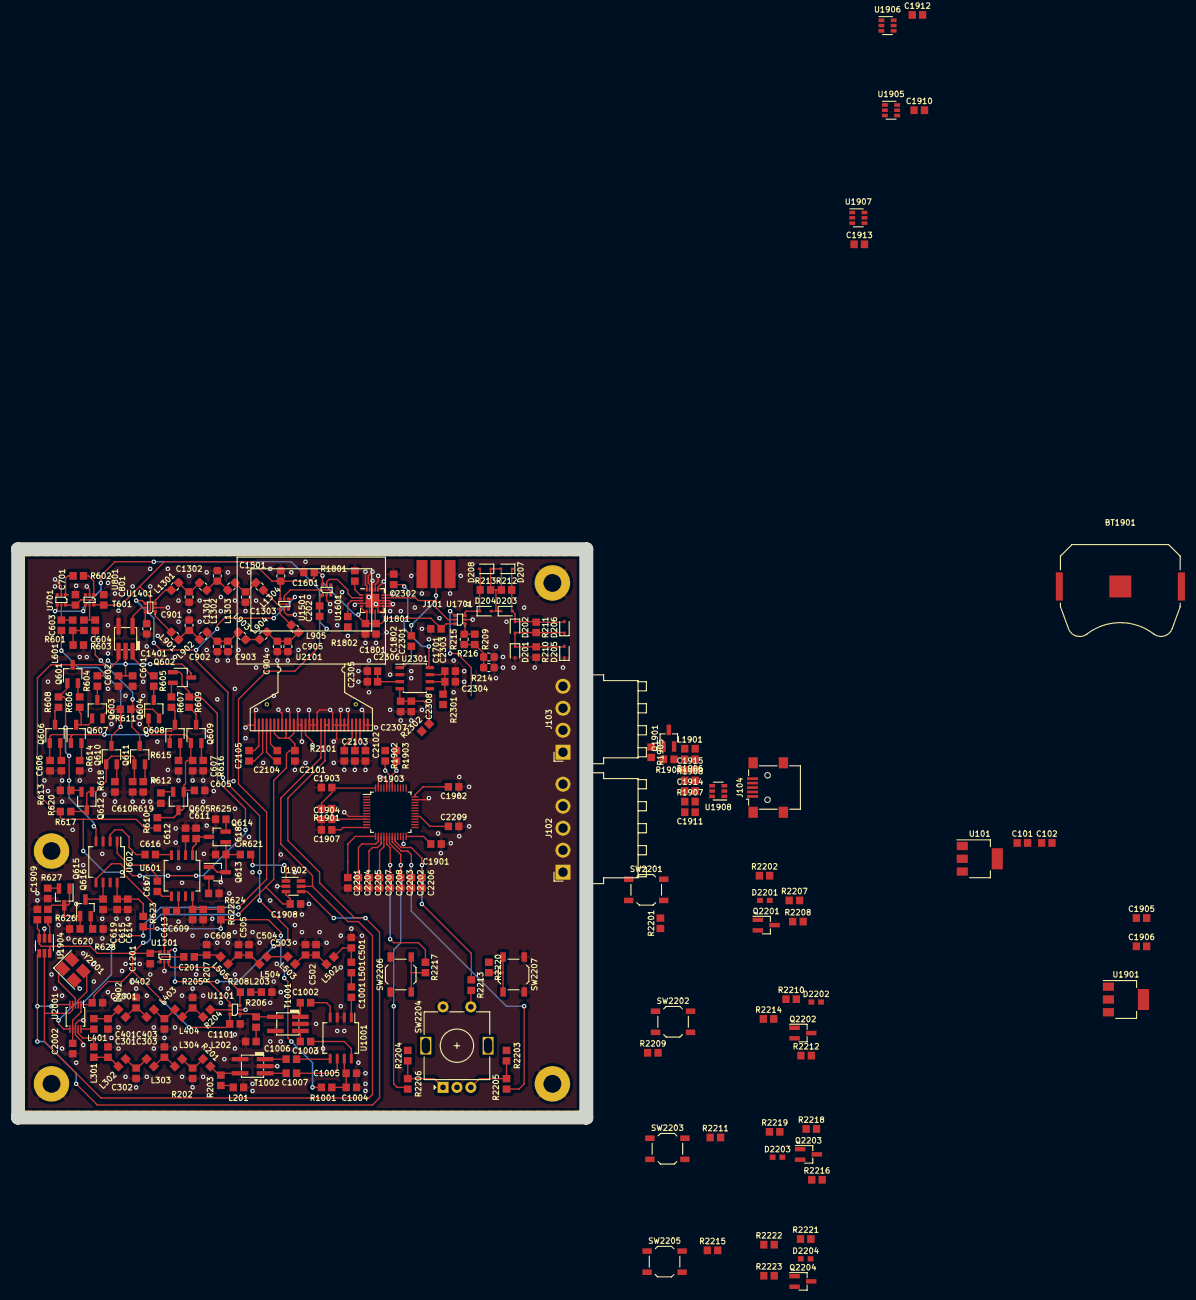
[picture p19: board generator_5351_rect_sine.kicad_pcb from above]

Board: 2 copper layers, 102.4 x 102.4 mm, 284 parts (0 on the bottom side), 191 nets.
